Element18592/N64-FRAM-Memory-Pak/README.md

# 256KB FRAM Memory Pak

This is a drop in replacement FRAM based memory card for the N64. It will fit in OEM Controller Pak housings or aftermarket housings with the same footprint.

PCB Thickness: 1.2mm

FRAM Memory Pak

FRAM Memory Pak housing
