Element18592/N64-FRAM-Memory-Pak/BOM.txt

C1 - 0.1 uF 0805
R1 - 1k ohm 0805
R2 - 10k ohm 0805
U1 - FM28V020-SG
