Element18592/N64-FRAM-Memory-Pak/(threads)

Thread 1 (2022-03-09):

Memory pak partially working

RigoHoward, 2022-03-09:
Hello, first of all many thanks for sharing the gerbers and detailed BOM on how build a "last long" DIY memory pak for N64.

I sourced every item (boards from jlcpcb, resistors, cap and fm28v020-sg ic)

I soldered everything in place, fire up perfect dark and i got the corrupted memory message. I attempted to repair the save data and it was ok.

Then i checked if the data was saved (after a few minutes) and it was there.
I fired up doom64 and mortal kombat 4 games and both show me an error regarding memory pak and both dont let me save at all.

So annoyingly the only game which it seems to be saving ok its perfect dark.

i already soldered 2 of this memory packs, one with the ramtron brand ic and another with cypress brand (same specs)

The both memory paks have the same behavior.
So there is any fix which its needed on the board?

Thank you again for doing this possible.

Element18592, 2022-03-10:
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

I haven't tested beyond Perfect Dark. Initially I got the normal repair save data message on first use, repaired it and saved a few times with Perfect Dark and verified the save was still okay and called it a wrap. This is something I made for fun and went based on the OEM board schematics so it should work but I'll have another look into it when I get some free time. Thanks for bringing it to my attention.

RigoHoward, 2022-03-10:
Hey thanks for your fast reply :)

I can report an update:
I notice the memory pak also works with hybrid heaven, but if you save on that game it will overwrite the perfect dark save.
On Quake 64 you can see the contents of the memory pak, but you cannot save.
On Mortal Kombat 4 a "memory pak exchanged" message its shown when you try to save

WilliamDingler, 2022-04-07:
I have experienced similar issues.

jago85, 2022-04-28:
Hi,
I've found this project today and had a look at the gerber data. My viewer has some problems, but I noticed a few things that could cause this issue. I'm not 100% sure, but maybe this is of some help for you:

- Pin 28 of U1 (VCC) is NOT connected to the supply voltage (only to a cap to GND)
- Pin 18 of the edge connector (CE) is only connected to a pull down resistor and thus has absolutely no effect (the chip enable logic is completely ignored)
- Pin 19 of the edge connector (A15) is used as /CE (which might be fine)
- as far as I can tell, the original board uses CE and A15 to generate the /CE for the SRAM (CE must be high and A15 must be low)

Element18592, 2022-05-19:
Thanks for sharing that. I did notice some of these issues as well. I changed the design layout before pushing it to look a bit better on the eye and I completely forgot to add back a few critical traces when I rearranged a few things. I've got the hopefully fixed boards here and have had them for some time I just haven't had the time to sit down and put them together and test them but hopefully I can do that sometime next week.

Retrofletch, 2022-06-16:
The available gerbers are the "non-fixed" ones then i assume?

breyell, 2022-10-14:
@Element18592 Did you ever get around to checking the fixed boards? Would love to order some but seems like the existing design has issues.

Element18592, 2022-10-14:
>

I completely forgot about it until I got your message. I assembled one up and everything is working fine on my end. I made sure to test the problem games people mentioned above and all of them save an load just fine for me. Below is a screenshot of  some of the games tested after wiping it and saving again.

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

breyell, 2022-10-14:
Wow, talk about a quick turnaround. Thanks a bunch for all of your work.

RigoHoward, 2022-10-15:
Glad to read the update :)
@Element18592

I saw you update the gerbers, the current source its the fixed one?
Thank you in advance ;)

Element18592, 2022-10-16:
>
Yes

Element18592, 2022-10-16:
> Glad to read the update :) @Element18592
>
> I saw you update the gerbers, the current source its the fixed one? Thank you in advance ;)

Yes

RigoHoward, 2022-10-17:
Nice!, i compared the older boards i have and after cutting 1 trace and also adding 2 jumper wires, now my fram memory pak its saving with alm the games i tested!

@Element18592 @jago85 thanks guys :)

RigoHoward, 2022-10-17:
And here it is:

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

Closed 2022-10-18.

Thread 2 (2022-10-18):

Open Source or Share Design Files?

breyell, 2022-10-18:
@Element18592 I just tried to order some from JLCPCB with enig and gold fingers but noticed I couldn't get a 45 degree chamfer because the board size is < 50mm x 50mm. Would you be open to sharing the design files so I could make a panel that would allow me to order with that option? I'd happily send some samples for free if you did!

Element18592, 2022-10-18:
> @Element18592 I just tried to order some from JLCPCB with enig and gold fingers but noticed I couldn't get a 45 degree chamfer because the board size is < 50mm x 50mm. Would you be open to sharing the design files so I could make a panel that would allow me to order with that option? I'd happily send some samples for free if you did!

These were designed with Eagle. If you're good with that I can upload the .brd here.

Thread 3 (2023-04-27):

Board Files

jbarker2160, 2023-04-27:
It would be nice to have board files for this(preferably KiCAD) so that changes could be made to accommodate changes such as to make the manual chamfering unnecessary and to make pick-and-place files.

Element18592, 2023-04-27:
I don't use KiCAD but the board files aren't necessary for chamfering the edges, even the more mainstream fab houses like JLC offer this option in their easy quote tool before checkout. As for the PnP issue, I'll upload a centroid file soon.

Element18592, 2023-04-28:
Send me a message on Discord: Element18592#1474
